Rpatel43/underwater-robotics/images/UnderwaterRobotics-2.jpg

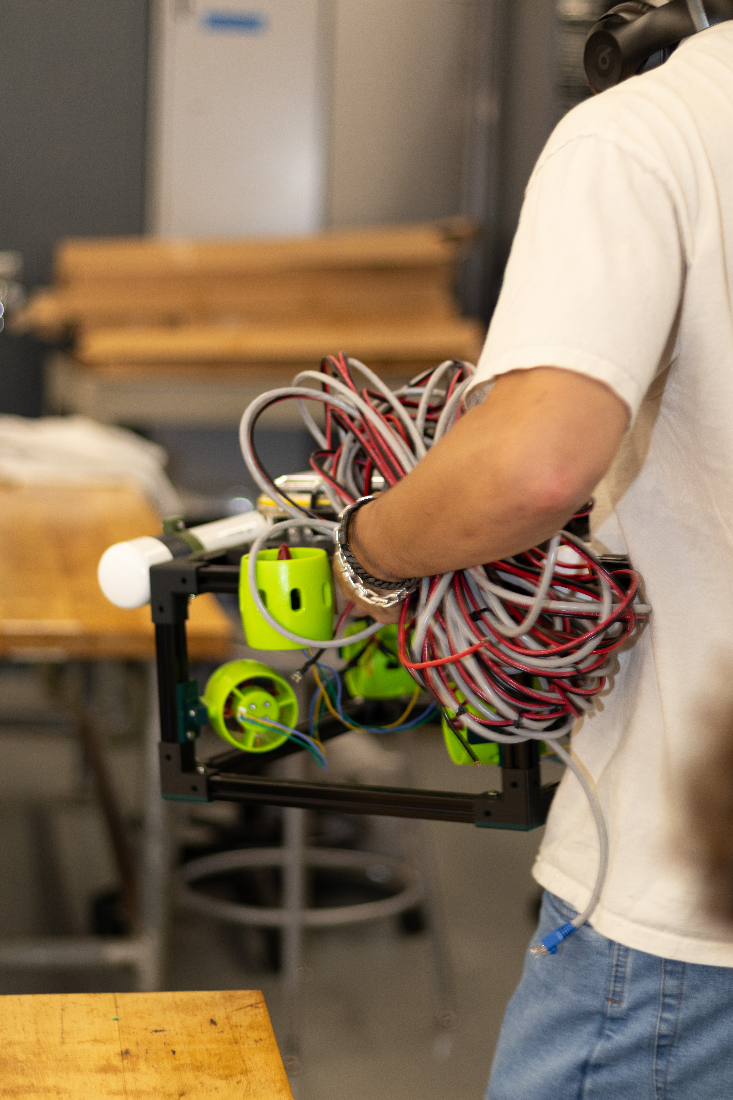
images/UnderwaterRobotics-2.jpg
