Rpatel43/underwater-robotics/images/UnderwaterRobotics-4.jpg

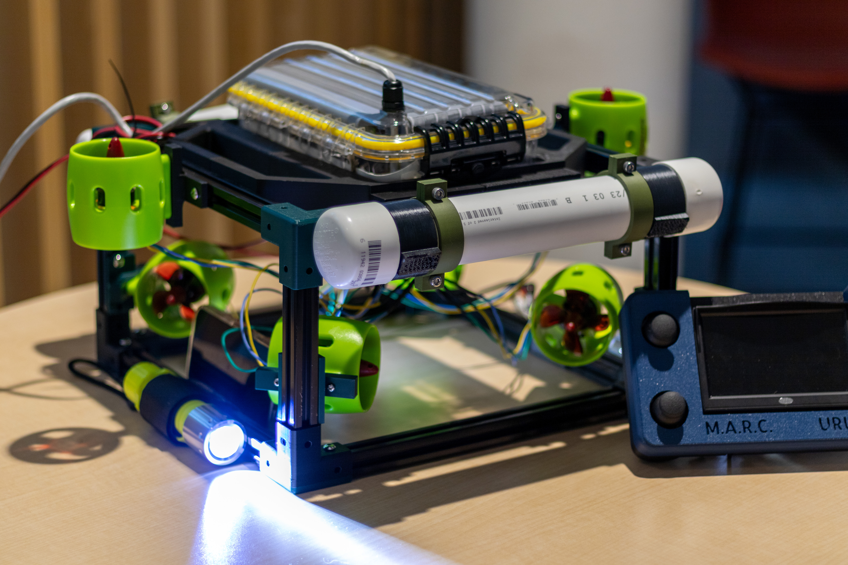
images/UnderwaterRobotics-4.jpg
