Rpatel43/underwater-robotics/docs/TO DO.docx

TO DO

- Print waterproof box mount
- Reprint Arduino cage on controller
- Print Table for e-box
- Create layout for waterproof box internals
  - Arduino
  - Power busssssssssssy bussssssss
  - ESCs
  - ACDC converter
- Drill more holes in waterproof box
- Fully assemble controller
  - Insert Arduino
- Assemble manipulator
  - BUY LOOOOONG SCREW!!!!!!!!!!
- Waterproofing
  - Servos
  - ESCs
- Compile all code
- Test 4 thruster configuration
- Mount vertical thrusters
- Camera shiznit
