Rpatel43/underwater-robotics/docs/Thruster Directions.jpg

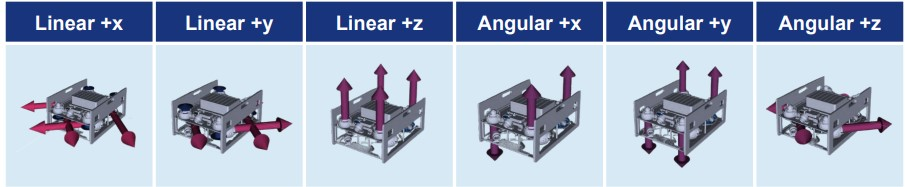
docs/Thruster Directions.jpg
