Rpatel43/underwater-robotics/images/UnderwaterRobotics-1.jpg

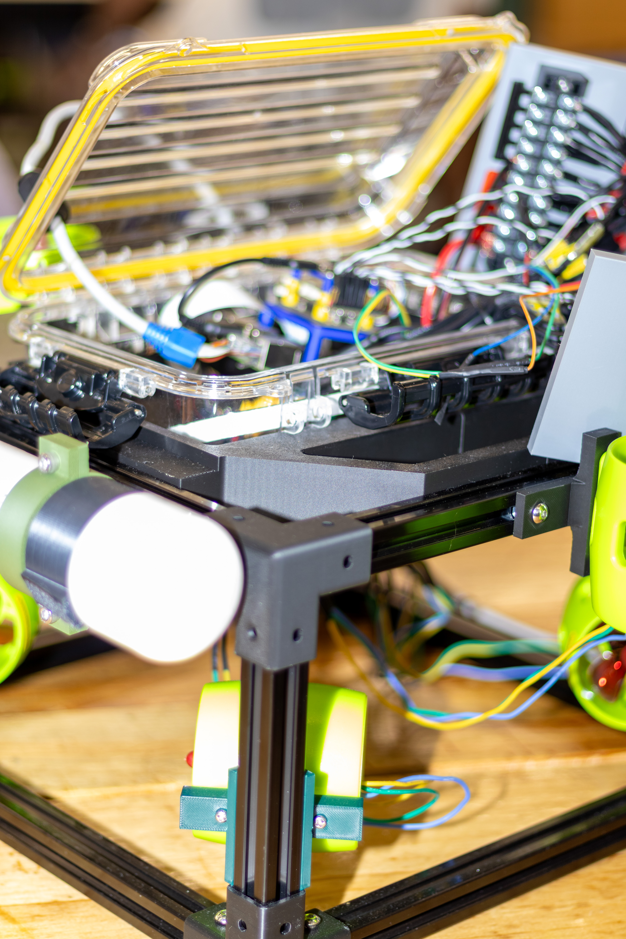
images/UnderwaterRobotics-1.jpg
