Rpatel43/underwater-robotics/images/UnderwaterRobotics-3.jpg

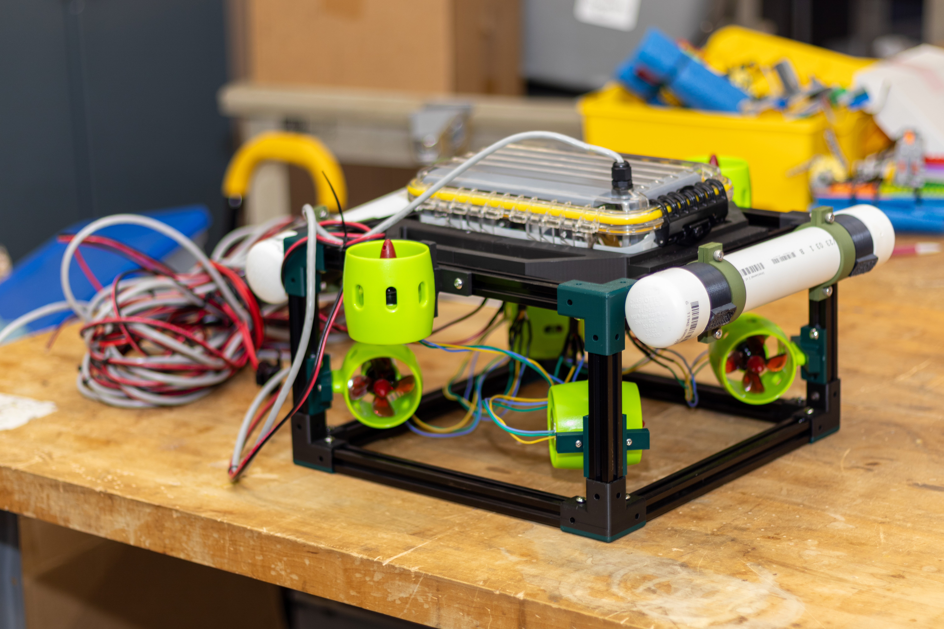
images/UnderwaterRobotics-3.jpg
