Rpatel43/underwater-robotics/images/UnderwaterRobotics-5.jpg

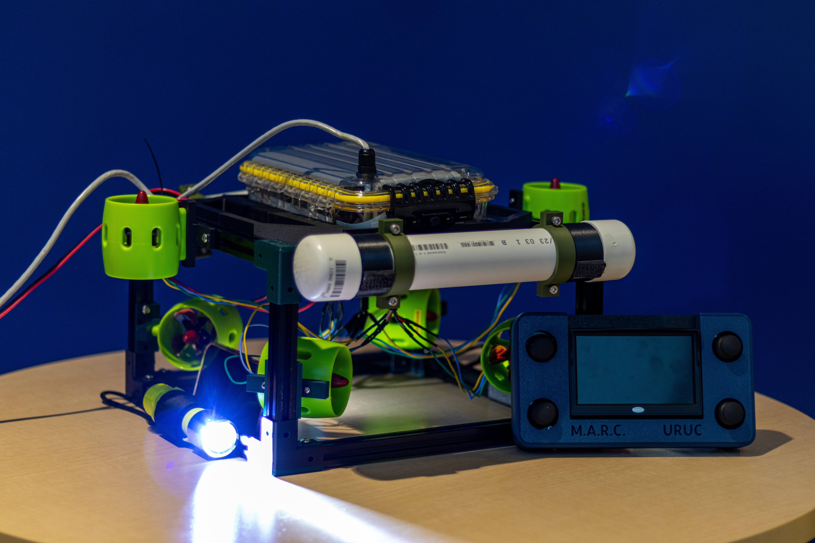
images/UnderwaterRobotics-5.jpg
