Rpatel43/underwater-robotics/images/UnderwaterRobotics-6.jpg

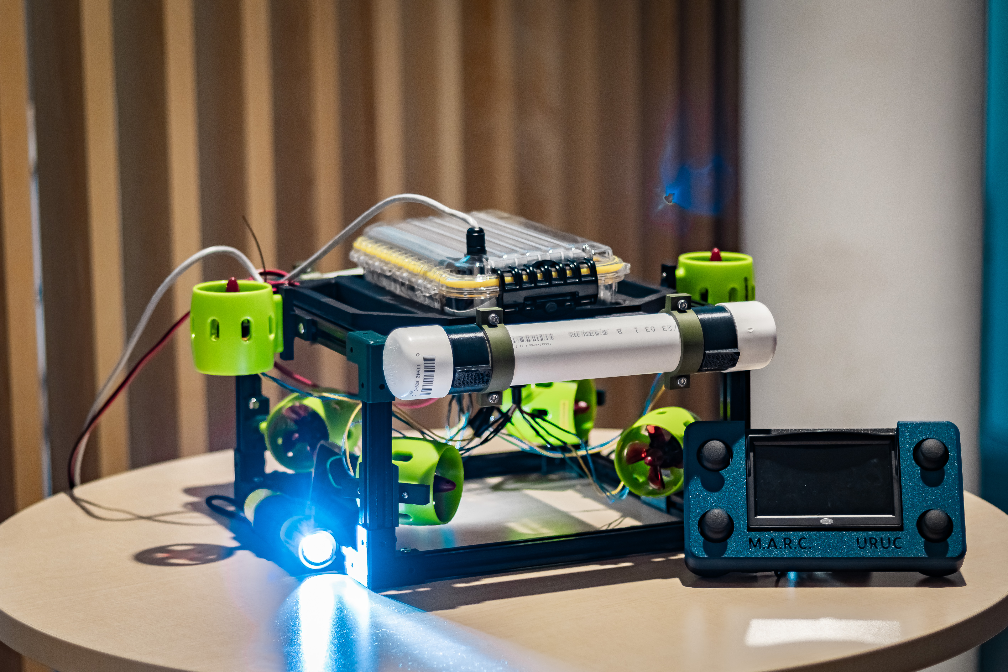
images/UnderwaterRobotics-6.jpg
