Rpatel43/underwater-robotics/docs/InitialOrderFormFall2024.xlsx

Description | Name | Amount | Price | Total | Link
Computer | ELEGOO UNO R3 Board ATmega328P with USB Cable(Arduino-Compatible) for Arduino | 2 | 14.99 | 29.98 | https://www.amazon.com/ELEGOO-Board-ATmega328P-ATMEGA16U2-Compliant/dp/B01EWOE0UU
Computer | ELEGOO MEGA R3 Board ATmega 2560 + USB Cable Compatible with Arduino IDE Projects RoHS Compliant | 6 | 20.99 | 125.94 | https://www.amazon.com/ELEGOO-Compatible-Arduino-Projects-Compliant/dp/B01H4ZLZLQ
Arduino breakout module | Electronics-Salon Screw Terminal Block Breakout Module, for Arduino MEGA-2560 R3. | 6 | 29.9 | 179.4 | https://www.amazon.com/Electronics-Salon-Terminal-Breakout-Arduino-MEGA-2560/dp/B07H9TJCWN
AV monitor | 5’’ Inch TFT LCD Car Color Rear View Monitor Screen for Parking Rear View Backup Camera with 2 Optional Bracket,Monitor only (5 inch) | 4 | 24.99 | 99.96 | https://www.amazon.com/Monitor-Parking-Optional-Bracket-Adhesive/dp/B019GQLNJU
Capture Card | Capture Card, USB Video Capture Card Device, Audio Video Converter Grabber for RCA to USB-Convert VHS Mini DV VCR Hi8 DVD to Digital, for PC TV Tape Player Camcorder, MAC Windows Vista Compatible | 4 | 11.99 | 47.96 | https://www.amazon.com/Capture-Converter-USB-Convert-Camcorder-Compatible/dp/B0CB6BW6X4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
DPDT Switch | 2PCS Momentary Polarity Reverse Switch DC 12V 20A Motor Control DPDT 6 Pin 3 Position (ON)-Off-(ON) AC 110V-220V Automatic Reset Boat Rocker Toggle Switch with Wire | 6 | 8.99 | 53.94 | https://www.amazon.com/Momentary-Polarity-Position-110V-220V-Automatic/dp/B097HCKSHJ
Servo | Traxxas 2056 High-Torque Waterproof Servo | 9 | 30.5 | 274.5 | https://www.amazon.com/Traxxas-2056-High-Torque-Waterproof-Servo/dp/B000XQ0QGY
12V motor | AUTOTOOLHOME 6-12V Mini DC Motor High Torque Gear for Traxxas R/C and Power Wheels PCB DIY Electric Drill | 12 | 6.89 | 82.68 | https://www.amazon.com/AUTOTOOLHOME-Torque-Traxxas-Wheels-Electric/dp/B01M58POHF
Propellers | 12pcs RC Boat Propellers 3-Vanes Props for 2mm Motor Shaft RC Model Ship (CW) | 1 | 13.99 | 13.99 | https://www.amazon.com/12pcs-Propellers-3-Vanes-Props-Motor/dp/B0BXRZMHC1
Underwater Thruster | U01 Underwater Thruster with 45A Bi-Directional ESC,12V~16V 2Kg Thrust Brushless Underwater Subsea Thruster/Propeller for ROV Boat（CCW） | 8 | 39.98 | 319.84 | https://www.amazon.com/ApisQueen-Underwater-Bi-Directional-Brushless-Propeller/dp/B0C9JR5Y5Y
Motor Controller | DROK DC Motor Driver 2pcs, L298 Dual H Bridge Motor Speed Controller DC 6.5V-27V 7A PWM Motor Regulator Board 12V 24V Electric Motor Control Module Industrial 160W with Optocoupler Isolation | 3 | 24.99 | 74.97 | https://www.amazon.com/DROK-Controller-Regulator-Industrial-Optocoupler/dp/B0D11B8727
USB Camera | Tbest Lightburn USB Kamera Mini Webcam,Lightburn Camera,Kameramodul USB,UsbKameramodul 140 Grad 2 Million Pixels 140° Wide Angle Lens USB Camera Module with Ov2710 Chip | 4 | 25.49 | 101.96 | https://www.amazon.com/Tbest-Lightburn-Kameramodul-UsbKameramodul-Million/dp/B0BX5MTVP6
50ft USB extender | LDKCOK USB 2.0 Type A Male to A Female Active Repeater Extension Cable 50ft, High Speed 480 Mbps | 4 | 18.99 | 75.96 | https://www.amazon.com/Female-Active-Repeater-Extension-50FT-15M/dp/B0777FDCX7
T slot aluminum for frame | 10PCS 48inch(1220mm) T Slot 2020 Aluminum Extrusion Profile for 3D Printer and CNC DIY, High-Strength European Standard Extruded Aluminum Linear Rail Guide, Anodizing Technology(Black) | 2 | 79.99 | 159.98 | https://www.amazon.com/Aluminum-Extrusion-High-Strength-Anodizing-Technology/dp/B09KZR37KG
Wire | NAOEVO 12 Gauge Wire 300FT, 2 Conductors Electrical Wire Red Black Cable, Flexible/Low Voltage/PVC 12 AWG Copper Clad Aluminum Extension Cord for Speaker Wire, LED Wire, Automotive Wire 12V/24V DC | 3 | 56.99 | 170.97 | https://www.amazon.com/NAOEVO-Conductors-Electrical-Extension-Automotive/dp/B0D7661669
Saltwater Motor | Johnson Pump 750 GPH Motor Cartridge Only | 6 | 31.84 | 191.04 | https://www.amazon.com/Johnson-Pump-America-Marine-Cartridge/dp/B001443FY4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
Waterproof Box | Plano Guide Series 3600 Field Box Waterproof Case, Medium, Waterproof Dry Box with Wrist Strap for Boat, Kayak, and Camping, Outdoor Gear Storage, 11"L x 7"W x 4"H, Clear/yellow | 4 | 32.99 | 131.96 | https://www.amazon.com/Plano-Guide-3600-Polycarbonate-Field/dp/B003FYMVXM
AV Camera | CCTV 1/3 CCD 1000tvl 6mm Indoor/Outdoor 6pcs IR LEDs Mini Video Camera Day/Night Waterproof Security Surveillance Camera with Bracket | 4 | 13.99 | 55.96 | https://www.amazon.com/Vanxse-1000tvl-Waterproof-Security-Surveillance/dp/B0C7132BTY
Heat Shrink | Ginsco 580 pcs 2:1 Heat Shrink Tubing Kit 6 Colors 11 Sizes Assorted Sleeving Tube Wrap Cable Wire Kit for DIY | 2 | 6.99 | 13.98 | https://www.amazon.com/Ginsco-580-pcs-Assorted-Sleeving/dp/B01MFA3OFA
Flashlight | Diving Flashlight with Rechargeable Power Scuba Dive Light IPX8 Waterproof Underwater Flashlight Snorkeling Diving LED High Lumens Torch, 3 Modes with Charger for Underwater Sports(2Pack) | 1 | 27.99 | 27.99 | https://www.amazon.com/HECLOUD-Professional-Flashlight-Waterproof-Snorkeling/dp/B089RYR917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
Light | SUPERNIGHT LED Strip Lights, 16.4FT 5M SMD 5050 Waterproof 300LEDs RGB Color Changing Flexible LED Light Strip | 1 | 14.99 | 14.99 | https://www.amazon.com/SUPERNIGHT-Waterproof-300LEDs-Changing-Flexible/dp/B00DTOAWZ2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
DepthCamera | Intel RealSense Depth Camera D435 | 2 | 308.87 | 617.74 | https://www.amazon.com/Intel-Realsense-D435-Webcam-FPS/dp/B07BLS5477
USB C to USB A | Anker USB to USB C Cable [2 Pack, 3FT], USB A to USB C Charger Cord for Samsung Galaxy S10 S10+, LG V30, Beats Fit Pro and More (USB 2.0, Black) | 1 | 7.99 | 7.99 | https://www.amazon.com/Intel-Realsense-D435-Webcam-FPS/dp/B07BLS5477
Raspberry Pi Case | Raspberry Pi 4 Fan ABS Case with Cooling Fan, Heatsink, Simple Removable Top Cover for Pi 4 Model B/ 4B | 1 | 11.99 | 11.99 | https://www.amazon.com/iUniker-Raspberry-Aluminium-Heatsink-Supply/dp/B07D3S4KBK
 | ELEGOO Rapid PLA Plus Filament 1.75mm Black 1KG, PLA+ 3D Printer Filament for 30-600 mm/s High Speed Printing, Dimensional Accuracy +/- 0.02 mm, 1kg Cardboard Spool(2.2lbs) | 1 | 14.99 | 14.99 | https://www.amazon.com/ELEGOO-Filament-Printing-Dimensional-Cardboard/dp/B0C6XG88RG
 | ABS Plastic Sheet 12" x 16" x 0.06" 6 Pack,Moldable Plastic Sheets | 2 | 16.99 | 33.98 | https://www.amazon.com/dp/B0BJDMNWJP?s=industrial&sp_csd=d2lkZ2V0TmFtZT1zcF9kZXRhaWw
 | W&O Wireless Controller Compatible with Xbox 360 2.4GHZ Gamepad Joystick Wireless Controller Compatible with Xbox 360 and PC Windows 7,8,10,11 with Receiver (Black) | 1 | 22.99 | 22.99 | https://www.amazon.com/Wireless-Controller-Compatible-Joystick-Receiver/dp/B09WQGQ6D2
 | Install Link 14 Gauge Speaker Wire (Speaker Cable) for Car, Home or RV Audio Cable, 100ft, CCA | 1 | 16.95 | 16.95 | https://www.amazon.com/Install-Link-Gauge-Speaker-Audio/dp/B0BYCST1YC?sp_csd=d2lkZ2V0TmFtZT1zcF9hdGY
 | Southwire 55669023 Primary Wire; 14-Gauge Bulk Spool; 100-Feet; White | 1 | 25.76 | 25.76 | https://www.amazon.com/Southwire-55669023-Primary-14-Gauge-100-Feet/dp/B000PALRY8
 | ELEGOO 120pcs Multicolored Dupont Wire 40pin Male to Female, 40pin Male to Male, 40pin Female to Female Breadboard Jumper Ribbon Cables Kit Compatible with Arduino Projects | 2 | 6.98 | 13.96 | https://www.amazon.com/Elegoo-EL-CP-004-Multicolored-Breadboard-arduino/dp/B01EV70C78
 | Lifehead 65mm On Road Rubber Tires& Wheels Rims 12mm Hex Hub for HPI Ken Block's Tamiya XV01 TT01 TT02B Kyosho FAZER MK2 Lc Racing PTG HSP RGT RC 3RACING D5 1/10 RC Rally Car | 1 | 22.99 | 22.99 | https://www.amazon.com/Lifehead-Rubber-Wheels-Blocks-3RACING/dp/B0BP43KF2S
 | Cyahvtl Laser Pointer, Tactical Flashlights 2000 Metres Green Long Range High Power Handheld Flashlight, Rechargeable Laser Pointer for USB, with Star Cap Adjustable Focus Suitable for Projecto | 2 | 24.29 | 48.58 | https://www.amazon.com/Cyahvtl-Flashlight-Rechargeable-Adjustable-Suitable/dp/B09V1C8827
 | Logitech G F710 Wireless Gamepad, 2.4 GHz Wireless with USB Nano-Receiver, Controller Dual Vibration Feedback, 4 Switch D-Pad, PC - Grey/Black | 1 | $39.99 | 39.99 | Amazon.com: Logitech G F710 Wireless Gamepad, 2.4 GHz Wireless with USB Nano-Receiver, Controller Dual Vibration Feedback, 4 Switch D-Pad, PC - Grey/Black (https://www.amazon.com/Logitech-Wireless-Nano-Receiver-Controller-Vibration/dp/B0041RR0TW?th=1)
 | DC 24V 50N 11LB/5Kg Suction Holding sucker round electric Magnet Solenoid lifting cylinder Electromagnet 25 x 11mm | 1 | 26.89 | 26.89 | https://www.amazon.com/uxcell-Electric-Lifting-Electromagnet-Solenoid/dp/B01N3386NB
 | SOS leak sensor for electronics casing | 1 | $32 | 32 | https://bluerobotics.com/store/sensors-cameras/leak-sensor/sos-leak-sensor/
 | Oatey 31190 Heavy Duty Wax Bowl Ring, 3" or 4" waste lines | 4 | 6 | 24 | https://www.amazon.com/Oatey-31190-Heavy-waste-lines/dp/B000KKMWYC
 | Dura-Gold Premium 80 Grit Gold PSA Longboard Sandpaper 20 Yard Long Continuous Roll, 2-3/4" Wide - Self Adhesive Stickyback Sandpaper for Automotive, Woodworking, Air File Sanders, Hand Sanding Blocks | 1 | 20.99 | 20.99 | https://www.amazon.com/Dura-Gold-Continuous-Stickyback-Automotive-Woodworking/dp/B001AV953Q
