Rpatel43/underwater-robotics/docs/Parts List.xlsx

Order Form.xlsx
 | Item | Cost | Quantity | Total | Link | Additional Notes | Sub-teams
Structure | 1/2in PVC |  |  |  |  |  | Design | Programming/Electronics
 | Aluminum |  |  |  |  |  | Michael | Dimitri
 | 1/2in PVC Connectors |  |  |  |  |  | Ronit | Cilantro
 | 1 1/2in PVC (floatation) |  |  |  |  |  | Joey | Jack
Power | Car Battery |  |  |  |  |  | Jib | Julia
 |  |  |  |  |  |  | Maddy | Aiden
Motors |  |  |  |  |  |  | Simon
Servos
cable/wiring | Cat-6 |  |  |  |  |  | Software | Arduino (https://www.arduino.cc/en/software)
 | Wires
Electronics | Arduino
 | Portable Screen
 | Servos
 | Arduino Joystick
 | buttons
 | Switch
 | Raspberry Pi
 | Waterproof bottle
 | Cameras
Fasteners
Waterproofing | Mineral Oil
 | Epoxy
 | Vaseline
