Rpatel43/underwater-robotics/code/Final/BottomSide.ino

#include <Servo.h>

// Thrusters setup
#define MIN_THRUSTER_VALUE 1100
#define MAX_THRUSTER_VALUE 1900
#define JOYSTICK_CENTER_THRESHOLD_LOW 500
#define JOYSTICK_CENTER_THRESHOLD_HIGH 522

// Manipulator setup
#define SERVO_MIN 0
#define SERVO_CENTER 87
#define SERVO_MAX 180
#define SERVO_THRESHOLD 80
#define MOVEMENT_STEP 1
#define LOOP_DELAY 8

Servo thruster1; // Front left
Servo thruster2; // Front right
Servo thruster3; // Back left
Servo thruster4; // Back right
Servo thruster5; // Top left
Servo thruster6; // Top right

Servo clawServo;
#define CLAW_SERVO_PIN A0

Servo rotateServo;
#define ROTATE_SERVO_PIN A1


int claw_servo_position = SERVO_CENTER;
int rotate_servo_position = SERVO_CENTER;

// Function to map joystick input to thruster values
int mapJoystickToThruster(int joystickValue) 
{
  return constrain(map(joystickValue, 0, 1023, MIN_THRUSTER_VALUE, MAX_THRUSTER_VALUE), MIN_THRUSTER_VALUE, MAX_THRUSTER_VALUE);
}

// Function to map joystick input to servo values
int mapJoystickToServo(int joystickValue) 
{
  return constrain(map(joystickValue, 0, 1023, SERVO_MIN, SERVO_MAX), SERVO_MIN, SERVO_MAX);
}

// Function to control horizontal movement (forward, backward, left, right)
void controlHorizontalMovement(int xInput, int yInput) 
{
  int xMapped = map(xInput, 0, 1023, -400, 400);
  int yMapped = map(yInput, 0, 1023, -400, 400);

  int power1 = mapJoystickToThruster(-xMapped + yMapped);
  int power2 = mapJoystickToThruster(xMapped + yMapped);

  thruster1.writeMicroseconds(power1);
  thruster2.writeMicroseconds(power2);
  thruster3.writeMicroseconds(power2);
  thruster4.writeMicroseconds(power1);
}

// Function to control vertical movement
void controlVerticalMovement(int zInput) 
{
  int zPower = mapJoystickToThruster(zInput);
  thruster5.writeMicroseconds(zPower);
  thruster6.writeMicroseconds(zPower);
}

// Function for yaw of robot
void controlYaw(int yawInput) 
{
  int yawPower1 = mapJoystickToThruster(yawInput);
  int yawPower2 = mapJoystickToThruster(-yawInput);

  thruster1.writeMicroseconds(yawPower1);
  thruster2.writeMicroseconds(yawPower2);
  thruster3.writeMicroseconds(yawPower1);
  thruster4.writeMicroseconds(yawPower2);
}

// Function to control the claw servo and rotation servo
void controlManipulator(int clawInput, int rotateInput) 
{
  if (clawInput > SERVO_CENTER + SERVO_THRESHOLD) 
  {
    claw_servo_position -= MOVEMENT_STEP;  // Open claw
  } 
  else if (clawInput < SERVO_CENTER - SERVO_THRESHOLD) 
  {
    claw_servo_position += MOVEMENT_STEP;  // Close claw
  }

  if (rotateInput > SERVO_CENTER + SERVO_THRESHOLD) 
  {
    rotate_servo_position += MOVEMENT_STEP;  // Rotate claw CW
  } 
  else if (rotateInput < SERVO_CENTER - SERVO_THRESHOLD) 
  {
    rotate_servo_position -= MOVEMENT_STEP;  // Rotate claw CCW
  }

  claw_servo_position = constrain(claw_servo_position, SERVO_MIN, SERVO_MAX);
  rotate_servo_position = constrain(rotate_servo_position, SERVO_MIN, SERVO_MAX);

  // Move servos
  clawServo.write(claw_servo_position);
  rotateServo.write(rotate_servo_position);
}

void setup() 
{
  thruster1.attach(3);
  thruster2.attach(5);
  thruster3.attach(6);
  thruster4.attach(9);
  thruster5.attach(10);
  thruster6.attach(11);

  clawServo.attach(CLAW_SERVO_PIN);
  rotateServo.attach(ROTATE_SERVO_PIN);

  Serial.begin(9600);

  clawServo.write(SERVO_CENTER);
  rotateServo.write(SERVO_CENTER);
}

void loop() {
  if (Serial.available() > 0) 
  {
    //Expecting 6 values: x1, y1, x2, y2, x3, y3
    int joy1X = Serial.parseInt(); // Forward/Backward
    int joy1Y = Serial.parseInt(); // Left/Right
    int joy2X = Serial.parseInt(); // Up/Down
    int joy2Y = Serial.parseInt(); // Yaw
    int joy3X = Serial.parseInt(); // Claw open/close
    int joy3Y = Serial.parseInt(); // Claw rotation

    controlHorizontalMovement(joy1X, joy1Y);
    controlVerticalMovement(joy2X);
    controlYaw(joy2Y);
    controlManipulator(joy3X, joy3Y);
  }
}
